alejandroterram/RobotDibujador/Control_Final_Robot_DIC/4.jpg

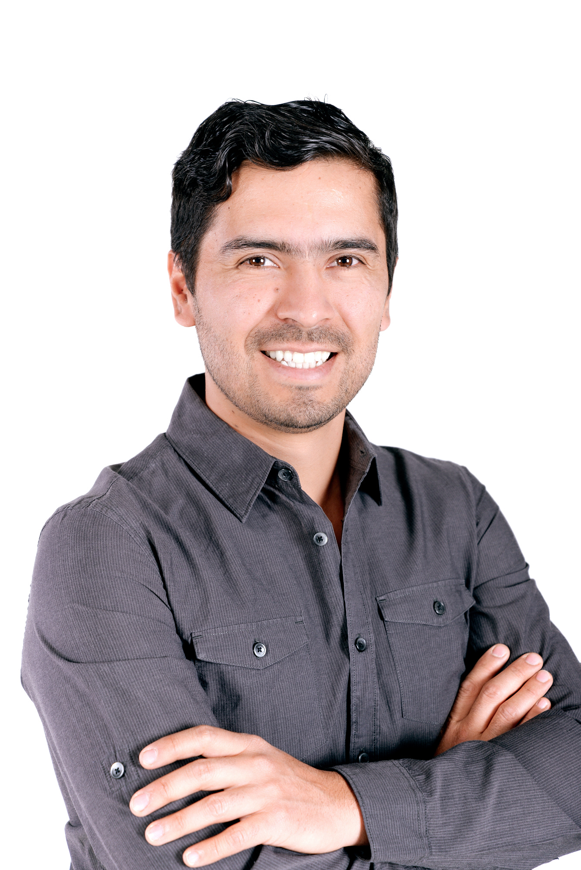
Control_Final_Robot_DIC/4.jpg
