alejandroterram/RobotDibujador/Control_Final_Robot_DIC/input_image.jpg

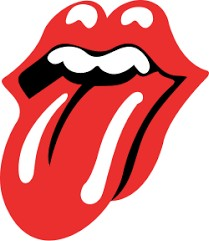
Control_Final_Robot_DIC/input_image.jpg
