alejandroterram/RobotDibujador/Control_Final_Robot_DIC/2.jpeg

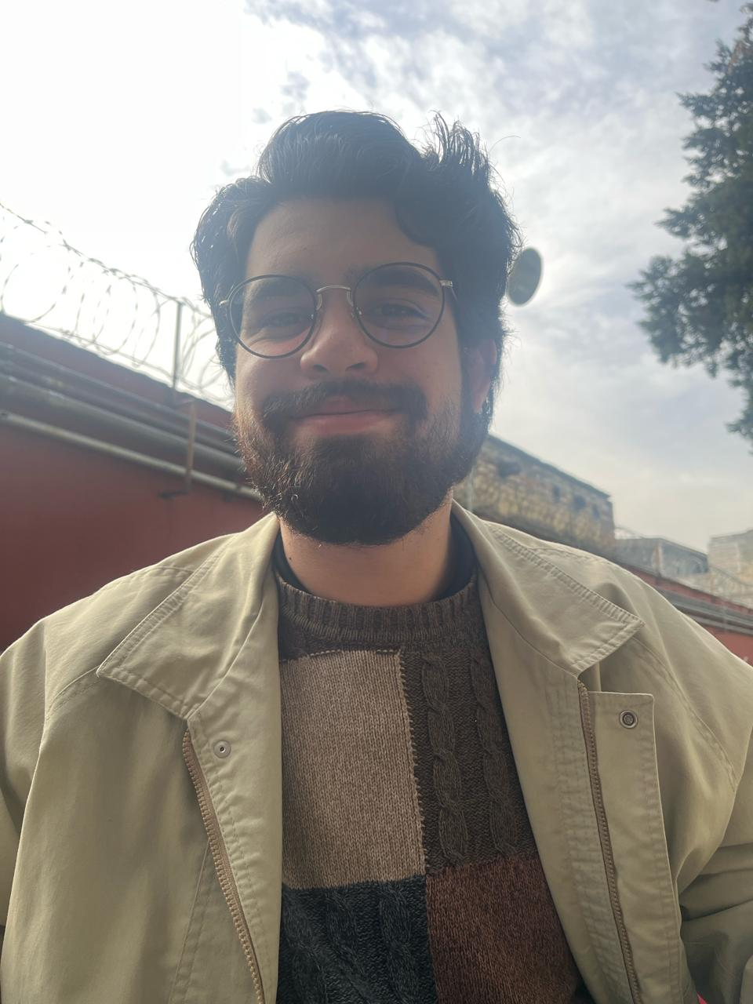
Control_Final_Robot_DIC/2.jpeg
