alejandroterram/RobotDibujador/Control_Final_Robot_DIC/3.jpg

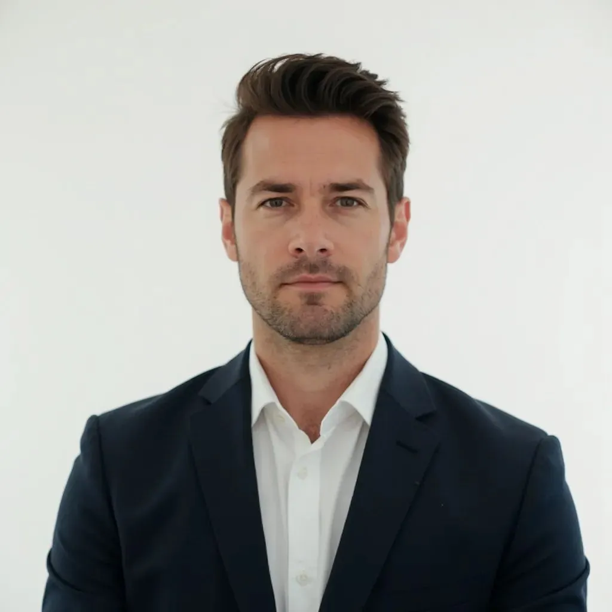
Control_Final_Robot_DIC/3.jpg
